Andrew-Naichuk/OBJECT-CC/docs/object-poster-dark.webp

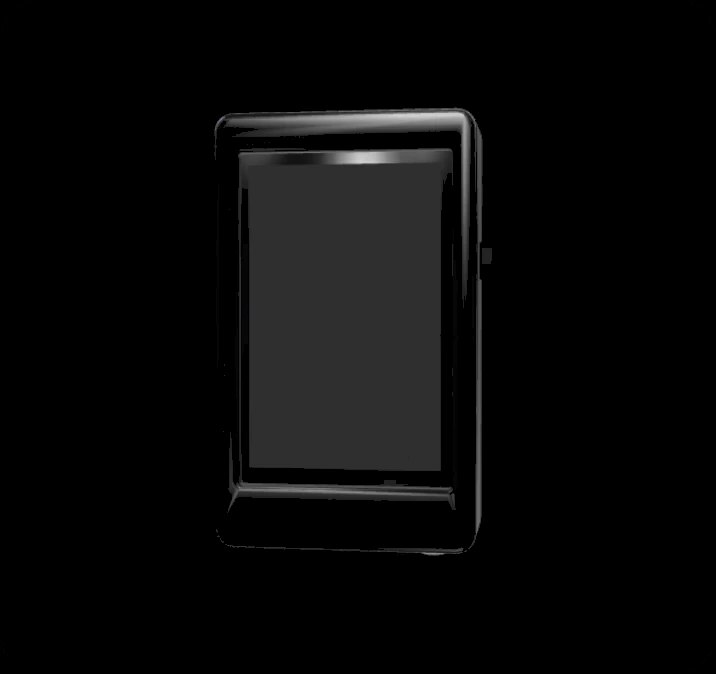
docs/object-poster-dark.webp
