Andrew-Naichuk/OBJECT-CC/docs/object-poster-light.webp

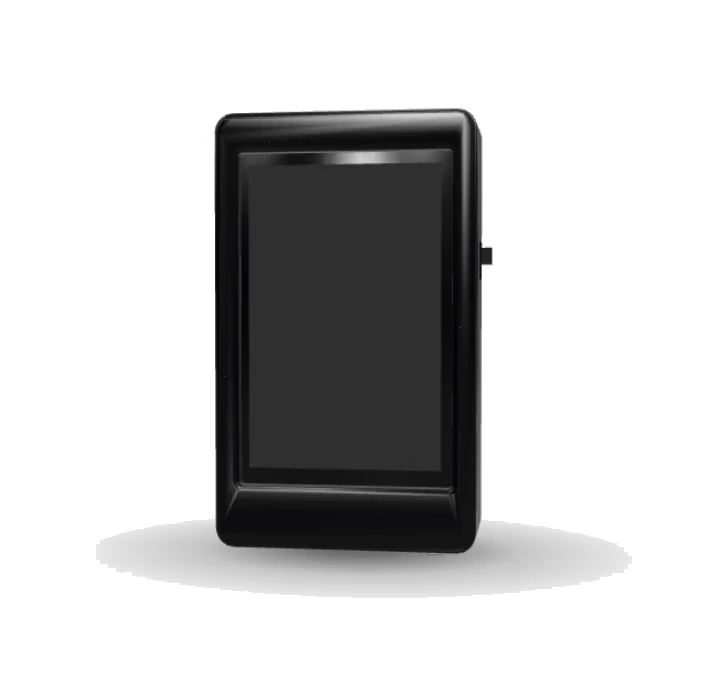
docs/object-poster-light.webp
