Andrew-Naichuk/OBJECT-CC/(commit log)

2026-09-30 schematic added
2026-09-30 debounce and schematic update
2026-10-01 days fix and connect cinfirm
    [xiao_oled.ino]
2026-10-02 battery level update
2026-10-09 device model added to settings
2026-10-09 gps zero point fix
    [xiao_oled.ino]
